holiofox/STI--2024-S02/README.md

# STI--2024-S02

HUST 电工基地 S02 小组文件
这个仓库用来存储我们的模块文件
