holiofox/STI--2024-S02/23B/2023B_DDS法_F429/报告/同轴电缆.png

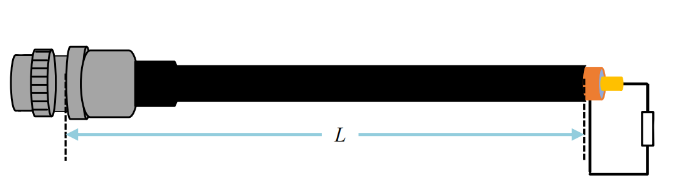
23B/2023B_DDS法_F429/报告/同轴电缆.png
