holiofox/STI--2024-S02/模块库/AD9833/AD9833.c

#include "AD9833.h"

#include "stm32f4xx.h"





void MX_GPIO_Init(void)
{
    GPIO_InitTypeDef GPIO_InitStruct;

    /* GPIO Ports Clock Enable */
//    RCC_AHB1PeriphClockCmd(RCC_AHB1Periph_GPIOH, ENABLE);
    RCC_AHB1PeriphClockCmd(RCC_AHB1Periph_GPIOC, ENABLE);

    /*Configure GPIO pin Output Level */
    GPIO_ResetBits(GPIOC, DDS_FSY1_Pin | DDS_CLK_Pin | DDS_DAT_Pin | DDS_FSY0_Pin);

    /*Configure GPIO pins : PEPin PEPin PEPin PEPin */
    GPIO_InitStruct.GPIO_Pin = DDS_FSY1_Pin | DDS_CLK_Pin | DDS_DAT_Pin | DDS_FSY0_Pin;
    GPIO_InitStruct.GPIO_Mode = GPIO_Mode_OUT;
    GPIO_InitStruct.GPIO_OType = GPIO_OType_PP;
    GPIO_InitStruct.GPIO_PuPd = GPIO_PuPd_NOPULL;
    GPIO_InitStruct.GPIO_Speed = GPIO_Speed_50MHz;
    GPIO_Init(GPIOC, &GPIO_InitStruct);
}






//***************************
//		Pin assign	   	
//		STM32			AD9833
//		PF12 		---> FSYNC
//		PF1 		---> SCK
//		PG6 		---> DAT
//		PC9			---> FSY1
//***************************	

	/*端口定义 */ 
//	#define PORT_FSYNC	GPIOB
//	#define PIN_FSYNC	GPIO_Pin_15  //PC7

//	#define PORT_SCK	GPIOB
//	#define PIN_SCK		GPIO_Pin_14  //PC8

//	#define PORT_DAT	GPIOB
//	#define PIN_DAT		GPIO_Pin_13  //PC9

//	#define PORT_FSY1		GPIOB
//	#define PIN_FSY1		GPIO_Pin_12  //数字电位器片选//PA8

//****************************************************************




#define FSY0_0()        GPIO_ResetBits(DDS_FSY0_GPIO_Port, DDS_FSY0_Pin)
#define FSY0_1()        GPIO_SetBits(DDS_FSY0_GPIO_Port, DDS_FSY0_Pin)

#define SCK_0()         GPIO_ResetBits(DDS_CLK_GPIO_Port, DDS_CLK_Pin)
#define SCK_1()         GPIO_SetBits(DDS_CLK_GPIO_Port, DDS_CLK_Pin)

#define DAT_0()         GPIO_ResetBits(DDS_DAT_GPIO_Port, DDS_DAT_Pin)
#define DAT_1()         GPIO_SetBits(DDS_DAT_GPIO_Port, DDS_DAT_Pin)

#define FSY1_0()        GPIO_ResetBits(DDS_FSY1_GPIO_Port, DDS_FSY1_Pin)
#define FSY1_1()        GPIO_SetBits(DDS_FSY1_GPIO_Port, DDS_FSY1_Pin)
//初始化AD9833 GPIO

//void AD9833_Init_GPIO()
//{
//    GPIO_InitTypeDef GPIO_InitStructure;

//	RCC_APB2PeriphClockCmd(RCC_APB2Periph_GPIOB, ENABLE);

//	GPIO_InitStructure.GPIO_Pin = PIN_FSY0|PIN_SCK|PIN_DAT|PIN_FSY1; 
//    GPIO_InitStructure.GPIO_Speed = GPIO_Speed_50MHz;
//    GPIO_InitStructure.GPIO_Mode = GPIO_Mode_Out_PP;
//    GPIO_Init(PORT_SCK, &GPIO_InitStructure);



//}



/*
*********************************************************************************************************
*	函 数 名: AD9833_Delay
*	功能说明: 时钟延时
*	形    参: 无
*	返 回 值: 无
*********************************************************************************************************
*/
static void AD9833_Delay(void)
{
	uint16_t i;
	for (i = 0; i < 1; i++);
}



/*
*********************************************************************************************************
*	函 数 名: AD9833_Write
*	功能说明: 向SPI总线发送16个bit数据
*	形    参: TxData : 数据
*	返 回 值: 无
*********************************************************************************************************
*/
void AD9833_Write(unsigned int TxData, unsigned char channel)
{
	unsigned char i;

	SCK_1();
	//AD9833_Delay();
	if (channel) {
		FSY1_1();
		//AD9833_Delay();
		FSY1_0();
		//AD9833_Delay();
	}
	else {
		FSY0_1();
		//AD9833_Delay();
		FSY0_0();
		//AD9833_Delay();
	}
	for(i = 0; i < 16; i++)
	{
		if (TxData & 0x8000)
			DAT_1();
		else
			DAT_0();
		
		AD9833_Delay();
		SCK_0();
		AD9833_Delay();		
		SCK_1();
		
		TxData <<= 1;
	}
	FSY0_1();
	
} 



/*
*********************************************************************************************************
*	函 数 名: AD9833_WaveSeting
*	功能说明: 向SPI总线发送16个bit数据
*	形    参: 1.Freq: 频率值, 0.1 hz - 12Mhz
			  2.Freq_SFR: 0 或 1
			  3.WaveMode: TRI_WAVE(三角波),SIN_WAVE(正弦波),SQU_WAVE(方波)
			  4.Phase : 波形的初相位，最后12位为相位数据，13位无所谓，14位表示是写入相位寄存器0还是1,使用的是寄存器0，所以输入范围为0~4095
*	返 回 值: 无
*********************************************************************************************************
*/ 
void AD9833_WaveSeting(double Freq,unsigned int Freq_SFR,unsigned int WaveMode,unsigned int Phase, unsigned char channel )
{

		int frequence_LSB,frequence_MSB,Phs_data;
		double   frequence_mid,frequence_DATA;
		long int frequence_hex;

		/*********************************计算频率的16进制值***********************************/
		frequence_mid=268435456/25;//适合25M晶振
		//如果时钟频率不为25MHZ，修改该处的频率值，单位MHz ，AD9833最大支持25MHz
		frequence_DATA=Freq;
		frequence_DATA=frequence_DATA/1000000;
		frequence_DATA=frequence_DATA*frequence_mid;
		frequence_hex=frequence_DATA;  //这个frequence_hex的值是32位的一个很大的数字，需要拆分成两个14位进行处理；
		frequence_LSB=frequence_hex&0x3fff;
		frequence_MSB=(frequence_hex>>14)&0x3fff;

		Phs_data=Phase|0xC000;	//相位值，D15、D14为1，表示向相位寄存器写入数据，只用相位0寄存器
		AD9833_Write(0x0100, channel); //复位AD9833,即RESET位为1
		AD9833_Write(0x2100, channel); //选择数据一次写入，B28位和RESET位为1，这种情况不能单独设置MSB\LSB，需要连续两次写入

		if(Freq_SFR==0)				  //把数据设置到设置频率寄存器0
		{
		 	frequence_LSB=frequence_LSB|0x4000;//D15 D14 为01表示向F0寄存器写入
		 	frequence_MSB=frequence_MSB|0x4000;
			 //使用频率寄存器0输出波形
			AD9833_Write(frequence_LSB, channel); //L14，选择频率寄存器0的低14位数据输入
			AD9833_Write(frequence_MSB, channel); //H14 频率寄存器的高14位数据输入
			AD9833_Write(Phs_data, channel);	//设置相位
			//AD9833_Write(0x2000); /**设置FSELECT位为0，芯片进入工作状态,频率寄存器0输出波形**/
	    }
		if(Freq_SFR==1)				//把数据设置到设置频率寄存器1
		{
			 frequence_LSB=frequence_LSB|0x8000;//D15 D14 为10表示向F0寄存器写入
			 frequence_MSB=frequence_MSB|0x8000;
			//使用频率寄存器1输出波形
			AD9833_Write(frequence_LSB, channel); //L14，选择频率寄存器1的低14位输入
			AD9833_Write(frequence_MSB, channel); //H14 频率寄存器1为
			AD9833_Write(Phs_data, channel);	//设置相位
			//AD9833_Write(0x2800); /**设置FSELECT位为0，设置FSELECT位为1，即使用频率寄存器1的值，芯片进入工作状态,频率寄存器1输出波形**/
		}

		if(WaveMode==TRI_WAVE) //输出三角波波形
		{if(Freq_SFR==0)
		 	AD9833_Write(0x2002, channel); 
			else if(Freq_SFR==1)
			AD9833_Write(0x2802, channel); 
				
		}
		if(WaveMode==SQU_WAVE)	//输出方波波形
		{if(Freq_SFR==0)
			AD9833_Write(0x2028, channel);
			else if(Freq_SFR==1)
			AD9833_Write(0x2828, channel);
				
		}
		if(WaveMode==SIN_WAVE)	//输出正弦波形
		{if(Freq_SFR==0)
			AD9833_Write(0x2000, channel);
			else if(Freq_SFR==1)
							AD9833_Write(0x2800, channel);
		}

}


/*
*********************************************************************************************************
*	函 数 名: AD9833_WaveSeting_Double
*	功能说明: 向SPI总线发送16个bit数据
*	形    参: 1.Freq: 频率值, 0.1 hz - 12Mhz
			  2.Freq_SFR: 0 或 1
			  3.WaveMode: TRI_WAVE(三角波),SIN_WAVE(正弦波),SQU_WAVE(方波)
			  4.Phase : 波形1的初相位,调节该值可调整两个波形之间的相位差(并非与360度一比一对应)
*	返 回 值: 无
*********************************************************************************************************
*/ 
void AD9833_WaveSeting_Double(double Freq,unsigned int Freq_SFR,unsigned int WaveMode,unsigned int Phase)
{

		int frequence_LSB,frequence_MSB,Phs_data;
		double   frequence_mid,frequence_DATA;
		long int frequence_hex;

		/*********************************计算频率的16进制值***********************************/
		frequence_mid=268435456/25;//适合25M晶振
		//如果时钟频率不为25MHZ，修改该处的频率值，单位MHz ，AD9833最大支持25MHz
		frequence_DATA=Freq;
		frequence_DATA=frequence_DATA/1000000;
		frequence_DATA=frequence_DATA*frequence_mid;
		frequence_hex=frequence_DATA;  //这个frequence_hex的值是32位的一个很大的数字，需要拆分成两个14位进行处理；
		frequence_LSB=frequence_hex; //frequence_hex低16位送给frequence_LSB
		frequence_LSB=frequence_LSB&0x3fff;//去除最高两位，16位数换去掉高位后变成了14位
		frequence_MSB=frequence_hex>>14; //frequence_hex高16位送给frequence_HSB
		frequence_MSB=frequence_MSB&0x3fff;//去除最高两位，16位数换去掉高位后变成了14位

		Phs_data=Phase|0xC000;	//相位值
		AD9833_Write(0x0100, 0); //复位AD9833,即RESET位为1
		AD9833_Write(0x2100, 0); //选择数据一次写入，B28位和RESET位为1
		AD9833_Write(0x0100, 1); //复位AD9833,即RESET位为1
		AD9833_Write(0x2100, 1); //选择数据一次写入，B28位和RESET位为1

		if(Freq_SFR==0)				  //把数据设置到设置频率寄存器0
		{
		 	frequence_LSB=frequence_LSB|0x4000;
		 	frequence_MSB=frequence_MSB|0x4000;
			 //使用频率寄存器0输出波形
			AD9833_Write(frequence_LSB, 0); //L14，选择频率寄存器0的低14位数据输入
			AD9833_Write(frequence_MSB, 0); //H14 频率寄存器的高14位数据输入
			AD9833_Write(Phs_data, 1);	//设置相位
			AD9833_Write(frequence_LSB, 1); //L14，选择频率寄存器0的低14位数据输入
			AD9833_Write(frequence_MSB, 1); //H14 频率寄存器的高14位数据输入
			//AD9833_Write(0x2000); /**设置FSELECT位为0，芯片进入工作状态,频率寄存器0输出波形**/
	    }
		if(Freq_SFR==1)				//把数据设置到设置频率寄存器1
		{
			 frequence_LSB=frequence_LSB|0x8000;
			 frequence_MSB=frequence_MSB|0x8000;
			//使用频率寄存器1输出波形
			AD9833_Write(frequence_LSB, 0); //L14，选择频率寄存器1的低14位输入
			AD9833_Write(frequence_MSB, 0); //H14 频率寄存器1为
			AD9833_Write(Phs_data, 1);	//设置相位
			AD9833_Write(frequence_LSB, 1); //L14，选择频率寄存器1的低14位输入
			AD9833_Write(frequence_MSB, 1); //H14 频率寄存器1为
			//AD9833_Write(0x2800); /**设置FSELECT位为0，设置FSELECT位为1，即使用频率寄存器1的值，芯片进入工作状态,频率寄存器1输出波形**/
		}

		if(WaveMode==TRI_WAVE) //输出三角波波形
		{
			if(Freq_SFR == 0)
			{
			AD9833_Write(0x2002, 0); 
			AD9833_Write(0x2002, 1);
			}
			else if (Freq_SFR == 1)
			{
			AD9833_Write(0x2802, 0); 
			AD9833_Write(0x2802, 1);
			}
		}			
		if(WaveMode==SQU_WAVE)	//输出方波波形
		{
			if(Freq_SFR == 0)
			{
			AD9833_Write(0x2028, 0); 
			AD9833_Write(0x2028, 1); 
			}
			else if(Freq_SFR == 1)
			{
			AD9833_Write(0x2828, 0); 
			AD9833_Write(0x2828, 1); 
			}
		}
		if(WaveMode==SIN_WAVE)	//输出正弦波形
		{
			if(Freq_SFR == 0)
			{
			AD9833_Write(0x2000, 0); 
			AD9833_Write(0x2000, 1);
			}
			else if(Freq_SFR == 1)
			{
			AD9833_Write(0x2800, 0); 
			AD9833_Write(0x2800, 1);
			}
		}

}
