holiofox/STI--2024-S02/23B/2023B_TDR时域法_F429/代码/User/tim/bsp_advance_tim.c

/**
  ******************************************************************************
  * @file    bsp_advance_tim.c
  * @author  STMicroelectronics
  * @version V1.0
  * @date    2015-xx-xx
  * @brief   通用定时器定时范例
  ******************************************************************************
  * @attention
  *
  * 实验平台:野火  STM32 F429 开发板  
  * 论坛    :http://www.firebbs.cn
  * 淘宝    :https://fire-stm32.taobao.com
  *
  ******************************************************************************
  */
  
#include "./tim/bsp_advance_tim.h"

/**
  * @brief  配置TIM复用输出PWM时用到的I/O
  * @param  无
  * @retval 无
  */
static void TIMx_GPIO_Config(void) 
{
	/*定义一个GPIO_InitTypeDef类型的结构体*/
	GPIO_InitTypeDef GPIO_InitStructure;

	/*开启LED相关的GPIO外设时钟*/
	RCC_AHB1PeriphClockCmd (ADVANCE_ICPWM_GPIO_CLK, ENABLE); 	

	/* 定时器复用引脚 */
	GPIO_PinAFConfig(ADVANCE_ICPWM_GPIO_PORT,ADVANCE_ICPWM_PINSOURCE,ADVANCE_ICPWM_AF); 
	
	/* 高级控制定时器PWM输入捕获引脚 */
	GPIO_InitStructure.GPIO_Pin = ADVANCE_ICPWM_PIN;	
	GPIO_Init(ADVANCE_ICPWM_GPIO_PORT, &GPIO_InitStructure);
}

 /**
  * @brief  高级控制定时器 TIMx,x[1,8]中断优先级配置
  * @param  无
  * @retval 无
  */
static void TIMx_NVIC_Configuration(void)
{
    NVIC_InitTypeDef NVIC_InitStructure; 
    // 设置中断组为0
   NVIC_PriorityGroupConfig(NVIC_PriorityGroup_4);	
		// 设置中断来源
    NVIC_InitStructure.NVIC_IRQChannel = ADVANCE_TIM_IRQn; 	
		// 设置抢占优先级
    NVIC_InitStructure.NVIC_IRQChannelPreemptionPriority = 3;	 
	  // 设置子优先级
    NVIC_InitStructure.NVIC_IRQChannelSubPriority = 0;	
    NVIC_InitStructure.NVIC_IRQChannelCmd = ENABLE;
    NVIC_Init(&NVIC_InitStructure);
}

/*
 * 注意：TIM_TimeBaseInitTypeDef结构体里面有5个成员，TIM6和TIM7的寄存器里面只有
 * TIM_Prescaler和TIM_Period，所以使用TIM6和TIM7的时候只需初始化这两个成员即可，
 * 另外三个成员是通用定时器和高级定时器才有.
 *-----------------------------------------------------------------------------
 * TIM_Prescaler         都有
 * TIM_CounterMode			 TIMx,x[6,7]没有，其他都有（基本定时器）
 * TIM_Period            都有
 * TIM_ClockDivision     TIMx,x[6,7]没有，其他都有(基本定时器)
 * TIM_RepetitionCounter TIMx,x[1,8]才有(高级定时器)
 *-----------------------------------------------------------------------------
 */


static void TIM_PWMINPUT_Config(void)
{
	TIM_TimeBaseInitTypeDef  TIM_TimeBaseStructure;
	TIM_ICInitTypeDef  TIM_ICInitStructure;
	
	// 开启TIMx_CLK,x[1,8] 
  RCC_APB2PeriphClockCmd(ADVANCE_TIM_CLK, ENABLE); 

  TIM_TimeBaseStructure.TIM_Period = 0xFFFF-1; 	
	// 高级控制定时器时钟源TIMxCLK = HCLK=180MHz 
	// 设定定时器频率为=TIMxCLK/(TIM_Prescaler+1)=100KHz
  TIM_TimeBaseStructure.TIM_Prescaler = 1800-1;	
  // 计数方式
  TIM_TimeBaseStructure.TIM_CounterMode=TIM_CounterMode_Up;	
	// 初始化定时器TIMx, x[1,8]
	TIM_TimeBaseInit(ADVANCE_TIM, &TIM_TimeBaseStructure);
	
	/* IC1捕获：上升沿触发 TI1FP1 */
  TIM_ICInitStructure.TIM_Channel = ADVANCE_IC1PWM_CHANNEL;
  TIM_ICInitStructure.TIM_ICPolarity = TIM_ICPolarity_Rising;
  TIM_ICInitStructure.TIM_ICSelection = TIM_ICSelection_DirectTI;
  TIM_ICInitStructure.TIM_ICPrescaler = TIM_ICPSC_DIV1;
  TIM_ICInitStructure.TIM_ICFilter = 0x0;
  TIM_PWMIConfig(ADVANCE_TIM, &TIM_ICInitStructure);
	
	/* IC2捕获：下降沿触发 TI1FP2 */	
	TIM_ICInitStructure.TIM_Channel = ADVANCE_IC2PWM_CHANNEL;
  TIM_ICInitStructure.TIM_ICPolarity = TIM_ICPolarity_Falling;
  TIM_ICInitStructure.TIM_ICSelection = TIM_ICSelection_IndirectTI;
  TIM_ICInitStructure.TIM_ICPrescaler = TIM_ICPSC_DIV1;
  TIM_ICInitStructure.TIM_ICFilter = 0x0;
  TIM_PWMIConfig(ADVANCE_TIM, &TIM_ICInitStructure);
	
	/* 选择定时器输入触发: TI1FP1 */
  TIM_SelectInputTrigger(ADVANCE_TIM, TIM_TS_TI1FP1);		

  /* 选择复位模式 */
  TIM_SelectSlaveMode(ADVANCE_TIM, TIM_SlaveMode_Reset);
  // 禁用主从模式
    TIM_SelectMasterSlaveMode(ADVANCE_TIM, TIM_MasterSlaveMode_Enable);
//  /* 使能高级控制定时器 */
//  TIM_Cmd(ADVANCE_TIM, ENABLE);

//  /* 使能捕获/比较2中断请求 */
//  TIM_ITConfig(ADVANCE_TIM, TIM_IT_CC1, ENABLE);
}

void Control_TIM_Measurement(FunctionalState enable)
{
    TIM_Cmd(ADVANCE_TIM, enable);  // 启动或停止定时器
}

// 任何需要开始测量的地方
void Start_Measurement(void)
{
    // 使能定时器
    TIM_Cmd(ADVANCE_TIM, ENABLE);
	// 使能定时器中断
    TIM_ITConfig(ADVANCE_TIM, TIM_IT_CC1, ENABLE);
}

// 任何需要停止测量的地方
void Stop_Measurement(void)
{
    // 禁用定时器
    TIM_Cmd(ADVANCE_TIM, DISABLE);
    // 禁用定时器中断
    TIM_ITConfig(ADVANCE_TIM, TIM_IT_CC1, DISABLE);
}
/**
  * @brief  初始化高级控制定时器定时，1ms产生一次中断
  * @param  无
  * @retval 无
  */
void TIMx_Configuration(void)
{
	TIMx_GPIO_Config();
	
	TIMx_NVIC_Configuration();	
  
	TIM_PWMINPUT_Config();
}

/*********************************************END OF FILE**********************/
