holiofox/STI--2024-S02/23B/2023B_DDS法_F429/代码/User/adc/bsp_adc.h

#ifndef __ADC_H
#define	__ADC_H


#include "stm32f4xx.h"

// RHEOSTAT: 滑动变阻器/电位器

// ADC DR寄存器宏定义，ADC转换后的数字值则存放在这里
#define RHEOSTAT_ADC_DR_ADDR    ((u32)ADC1+0x4c)
// ADC DR寄存器宏定义，ADC转换后的数字值则存放在这里
#define RHEOSTAT_ADC_DR_ADDR_1    ((u32)ADC2+0x4c)

// ADC IO宏定义
#define RHEOSTAT_ADC_GPIO_PORT    GPIOC
#define RHEOSTAT_ADC_GPIO_PIN     GPIO_Pin_1
#define RHEOSTAT_ADC_GPIO_CLK     RCC_AHB1Periph_GPIOC

// ADC IO宏定义
#define RHEOSTAT_ADC_GPIO_PORT_1    GPIOC
#define RHEOSTAT_ADC_GPIO_PIN_1   GPIO_Pin_3
#define RHEOSTAT_ADC_GPIO_CLK_1     RCC_AHB1Periph_GPIOC

// ADC 序号宏定义
#define RHEOSTAT_ADC              ADC1
#define RHEOSTAT_ADC_CLK          RCC_APB2Periph_ADC1
#define RHEOSTAT_ADC_CHANNEL      ADC_Channel_11

// ADC 序号宏定义
#define RHEOSTAT_ADC_1              ADC2
#define RHEOSTAT_ADC_CLK_1          RCC_APB2Periph_ADC2
#define RHEOSTAT_ADC_CHANNEL_1      ADC_Channel_13
 

// ADC DMA 通道宏定义，这里我们使用DMA传输
#define RHEOSTAT_ADC_DMA_CLK_1      RCC_AHB1Periph_DMA2
#define RHEOSTAT_ADC_DMA_CHANNEL_1  DMA_Channel_1
#define RHEOSTAT_ADC_DMA_STREAM_1   DMA2_Stream2   

// ADC DMA 通道宏定义，这里我们使用DMA传输
#define RHEOSTAT_ADC_DMA_CLK      RCC_AHB1Periph_DMA2
#define RHEOSTAT_ADC_DMA_CHANNEL  DMA_Channel_0
#define RHEOSTAT_ADC_DMA_STREAM   DMA2_Stream0  

void Rheostat_Init(void);
void Start_ADC_Conversion(void);
void Rheostat_ADC_Mode_Config(void);
void Rheostat_ADC_Mode_Config1(void);

#endif /* __ADC_H */
