holiofox/STI--2024-S02/23B/2023B_DDS法_F429/代码/User/rcc/bsp_clkconfig.c

/**
  ******************************************************************************
  * @file    bsp_clkconfig.c
  * @author  fire
  * @version V1.0
  * @date    2015-xx-xx
  * @brief   时钟配置驱动
  ******************************************************************************
  * @attention
  *
  * 实验平台:野火  STM32 F429 开发板  
  * 论坛    :http://www.firebbs.cn
  * 淘宝    :https://fire-stm32.taobao.com
  *
  ******************************************************************************
  */
#include "./rcc/bsp_clkconfig.h"
#include "stm32f4xx_rcc.h"

/*
 * 使用HSE时，设置系统时钟的步骤
 * 1、开启HSE ，并等待 HSE 稳定
 * 2、设置 AHB、APB2、APB1的预分频因子
 * 3、设置PLL的时钟来源
 *    设置VCO输入时钟 分频因子        m
 *    设置VCO输出时钟 倍频因子        n
 *    设置PLLCLK时钟分频因子          p
 *    设置OTG FS,SDIO,RNG时钟分频因子 q
 * 4、开启PLL，并等待PLL稳定
 * 5、把PLLCK切换为系统时钟SYSCLK
 * 6、读取时钟切换状态位，确保PLLCLK被选为系统时钟
 */

/*
 * m: VCO输入时钟 分频因子，取值2~63
 * n: VCO输出时钟 倍频因子，取值192~432
 * p: PLLCLK时钟分频因子  ，取值2，4，6，8
 * q: OTG FS,SDIO,RNG时钟分频因子，取值4~15
 * 函数调用举例，使用HSE设置时钟
 * SYSCLK=HCLK=180M,PCLK2=HCLK/2=90M,PCLK1=HCLK/4=45M
 * HSE_SetSysClock(25, 360, 2, 7);
 * HSE作为时钟来源，经过PLL倍频作为系统时钟，这是通常的做法
 
 * 系统时钟超频到216M爽一下
 * HSE_SetSysClock(25, 432, 2, 9);
 */
void HSE_SetSysClock(uint32_t m, uint32_t n, uint32_t p, uint32_t q)	
{
  __IO uint32_t HSEStartUpStatus = 0;
  
  // 使能HSE，开启外部晶振，野火F429使用 HSE=25M
  RCC_HSEConfig(RCC_HSE_ON);
	
  // 等待HSE启动稳定
	HSEStartUpStatus = RCC_WaitForHSEStartUp();

  if (HSEStartUpStatus == SUCCESS)
  {
    // 调压器电压输出级别配置为1，以便在器件为最大频率
		// 工作时使性能和功耗实现平衡
    RCC->APB1ENR |= RCC_APB1ENR_PWREN;
    PWR->CR |= PWR_CR_VOS;
		
		// HCLK = SYSCLK / 1
		RCC_HCLKConfig(RCC_SYSCLK_Div1);
		
		// PCLK2 = HCLK / 2
		RCC_PCLK2Config(RCC_HCLK_Div2);
		
		// PCLK1 = HCLK / 4
		RCC_PCLK1Config(RCC_HCLK_Div4);
		
    // 如果要超频就得在这里下手啦
		// 设置PLL来源时钟，设置VCO分频因子m，设置VCO倍频因子n，
		//  设置系统时钟分频因子p，设置OTG FS,SDIO,RNG分频因子q
		RCC_PLLConfig(RCC_PLLSource_HSE, m, n, p, q);
		
		// 使能PLL
		RCC_PLLCmd(ENABLE);
  
	  // 等待 PLL稳定
    while (RCC_GetFlagStatus(RCC_FLAG_PLLRDY) == RESET)
    {
    }   

/*-----------------------------------------------------*/
    //开启 OVER-RIDE模式，以能达到更高频率
    PWR->CR |= PWR_CR_ODEN;
    while((PWR->CSR & PWR_CSR_ODRDY) == 0)
    {
    }
    PWR->CR |= PWR_CR_ODSWEN;
    while((PWR->CSR & PWR_CSR_ODSWRDY) == 0)
    {
    }      
    // 配置FLASH预取指,指令缓存,数据缓存和等待状态
    FLASH->ACR = FLASH_ACR_PRFTEN 
		            | FLASH_ACR_ICEN 
		            | FLASH_ACR_DCEN 
		            | FLASH_ACR_LATENCY_5WS;
/*-----------------------------------------------------*/
		
		// 当PLL稳定之后，把PLL时钟切换为系统时钟SYSCLK
    RCC_SYSCLKConfig(RCC_SYSCLKSource_PLLCLK);

    // 读取时钟切换状态位，确保PLLCLK被选为系统时钟
    while (RCC_GetSYSCLKSource() != 0x08)
    {
    }
  }
  else
  { // HSE启动出错处理

    while (1)
    {
    }
  }
}

/*
 * 使用HSI时，设置系统时钟的步骤
 * 1、开启HSI ，并等待 HSI 稳定
 * 2、设置 AHB、APB2、APB1的预分频因子
 * 3、设置PLL的时钟来源
 *    设置VCO输入时钟 分频因子        m
 *    设置VCO输出时钟 倍频因子        n
 *    设置SYSCLK时钟分频因子          p
 *    设置OTG FS,SDIO,RNG时钟分频因子 q
 * 4、开启PLL，并等待PLL稳定
 * 5、把PLLCK切换为系统时钟SYSCLK
 * 6、读取时钟切换状态位，确保PLLCLK被选为系统时钟
 */

/*
 * m: VCO输入时钟 分频因子，取值2~63
 * n: VCO输出时钟 倍频因子，取值192~432
 * p: PLLCLK时钟分频因子  ，取值2，4，6，8
 * q: OTG FS,SDIO,RNG时钟分频因子，取值4~15
 * 函数调用举例，使用HSI设置时钟
 * SYSCLK=HCLK=180M,PCLK2=HCLK/2=90M,PCLK1=HCLK/4=45M
 * HSI_SetSysClock(16, 360, 2, 7);
 * HSE作为时钟来源，经过PLL倍频作为系统时钟，这是通常的做法
 
 * 系统时钟超频到216M爽一下
 * HSI_SetSysClock(16, 432, 2, 9);
 */

void HSI_SetSysClock(uint32_t m, uint32_t n, uint32_t p, uint32_t q)	
{
  __IO uint32_t HSIStartUpStatus = 0;
	
	// 把RCC外设初始化成复位状态
  RCC_DeInit();
  
  //使能HSI, HSI=16M
	RCC_HSICmd(ENABLE);
	
	// 等待 HSI稳定
	while (RCC_GetFlagStatus(RCC_FLAG_HSIRDY) == RESET)
	{
	}	
  // 读取 HSI 就绪状态
	HSIStartUpStatus = RCC->CR & RCC_CR_HSIRDY;
	
	// 只有 HSI就绪之后则继续往下执行
  if (HSIStartUpStatus == RCC_CR_HSIRDY)
  {
    // 调压器电压输出级别配置为1，以便在器件为最大频率
		// 工作时使性能和功耗实现平衡
    RCC->APB1ENR |= RCC_APB1ENR_PWREN;
    PWR->CR |= PWR_CR_VOS;
		
		// HCLK = SYSCLK / 1
		RCC_HCLKConfig(RCC_SYSCLK_Div1);
		
		// PCLK2 = HCLK / 2
		RCC_PCLK2Config(RCC_HCLK_Div2);
		
		// PCLK1 = HCLK / 4
		RCC_PCLK1Config(RCC_HCLK_Div4);
		
    // 如果要超频就得在这里下手啦
		// 设置PLL来源时钟，设置VCO分频因子m，设置VCO倍频因子n，
		//  设置系统时钟分频因子p，设置OTG FS,SDIO,RNG分频因子q
		RCC_PLLConfig(RCC_PLLSource_HSI, m, n, p, q);
		
		// 使能PLL
		RCC_PLLCmd(ENABLE);
  
	  // 等待 PLL稳定
    while (RCC_GetFlagStatus(RCC_FLAG_PLLRDY) == RESET)
    {
    }   

/*-----------------------------------------------------*/
    //开启 OVER-RIDE模式，以能达到更高频率
    PWR->CR |= PWR_CR_ODEN;
    while((PWR->CSR & PWR_CSR_ODRDY) == 0)
    {
    }
    PWR->CR |= PWR_CR_ODSWEN;
    while((PWR->CSR & PWR_CSR_ODSWRDY) == 0)
    {
    }      
    // 配置FLASH预取指,指令缓存,数据缓存和等待状态
    FLASH->ACR = FLASH_ACR_PRFTEN 
		            | FLASH_ACR_ICEN 
		            |FLASH_ACR_DCEN 
		            |FLASH_ACR_LATENCY_5WS;
/*-----------------------------------------------------*/
		
		// 当PLL稳定之后，把PLL时钟切换为系统时钟SYSCLK
    RCC_SYSCLKConfig(RCC_SYSCLKSource_PLLCLK);

    // 读取时钟切换状态位，确保PLLCLK被选为系统时钟
    while (RCC_GetSYSCLKSource() != 0x08)
    {
    }
  }
  else
  { // HSI启动出错处理
    while (1)
    {
    }
  }
}


// MCO1 PA8 GPIO 初始化
void MCO1_GPIO_Config(void)
{
  GPIO_InitTypeDef GPIO_InitStructure;
	RCC_AHB1PeriphClockCmd(RCC_AHB1Periph_GPIOA, ENABLE);
  
  // MCO1 GPIO 配置
  GPIO_InitStructure.GPIO_Pin = GPIO_Pin_8;
  GPIO_InitStructure.GPIO_Speed = GPIO_Speed_100MHz;
  GPIO_InitStructure.GPIO_Mode = GPIO_Mode_AF;
  GPIO_InitStructure.GPIO_OType = GPIO_OType_PP;
  GPIO_InitStructure.GPIO_PuPd = GPIO_PuPd_UP;  
  GPIO_Init(GPIOA, &GPIO_InitStructure); 
}

// MCO2 PC9 GPIO 初始化
void MCO2_GPIO_Config(void)
{
  GPIO_InitTypeDef GPIO_InitStructure;
	RCC_AHB1PeriphClockCmd(RCC_AHB1Periph_GPIOC, ENABLE);
  
  // MCO2 GPIO 配置
  GPIO_InitStructure.GPIO_Pin = GPIO_Pin_9;
  GPIO_InitStructure.GPIO_Speed = GPIO_Speed_100MHz;
  GPIO_InitStructure.GPIO_Mode = GPIO_Mode_AF;
  GPIO_InitStructure.GPIO_OType = GPIO_OType_PP;
  GPIO_InitStructure.GPIO_PuPd = GPIO_PuPd_UP;  
  GPIO_Init(GPIOC, &GPIO_InitStructure);
}
