holiofox/STI--2024-S02/23B/2023B_TDR时域法_F429/代码/User/tim/bsp_general_tim.h

#ifndef __GENERAL_TIM_H
#define	__GENERAL_TIM_H

#include "stm32f4xx.h"

#define GENERAL_OCPWM_PIN             GPIO_Pin_0              
#define GENERAL_OCPWM_GPIO_PORT       GPIOA                      
#define GENERAL_OCPWM_GPIO_CLK        RCC_AHB1Periph_GPIOA
#define GENERAL_OCPWM_PINSOURCE				GPIO_PinSource0
#define GENERAL_OCPWM_AF							GPIO_AF_TIM2

#define GENERAL_TIM           		    TIM2
#define GENERAL_TIM_CLK       		    RCC_APB1Periph_TIM2

#define GENERAL_TIM_IRQn					    TIM2_IRQn
#define GENERAL_TIM_IRQHandler        TIM2_IRQHandler


void TIMx_GPIO_Config(void);
void TIM_PWMOUTPUT_Config(void);

#endif /* __GENERAL_TIM_H */
