holiofox/STI--2024-S02/(commit log)

2024-07-09 修改readme
2024-07-15 增加了23年电赛B题代码和报告
    [标定.xls]
2024-07-15 上传了一些模块文件
    [标定.xls]
2024-07-15 增加了一些模块文件
    [标定.xls]
2024-07-15 添加了一些模块
2024-07-16 添加了模块文件
2024-07-16 添加了一些模块文件
