holiofox/STI--2024-S02/(notices)

Notices in the files:
23B/2023B_TDR时域法_F429/代码/User/touch/gt9xx.h:
This program is free software; you can redistribute it and/or modify
it under the terms of the GNU General Public License as published by
the Free Software Foundation; either version 2 of the License, or
(at your option) any later version.
